NI2O/SO2R/OTRSP/Boxinside.jpg

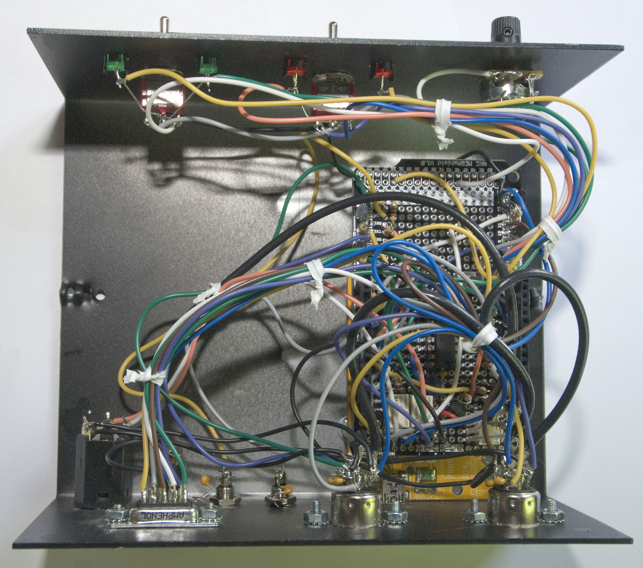
OTRSP/Boxinside.jpg
