NI2O/SO2R/OTRSP/SO2Rduino-V2.png

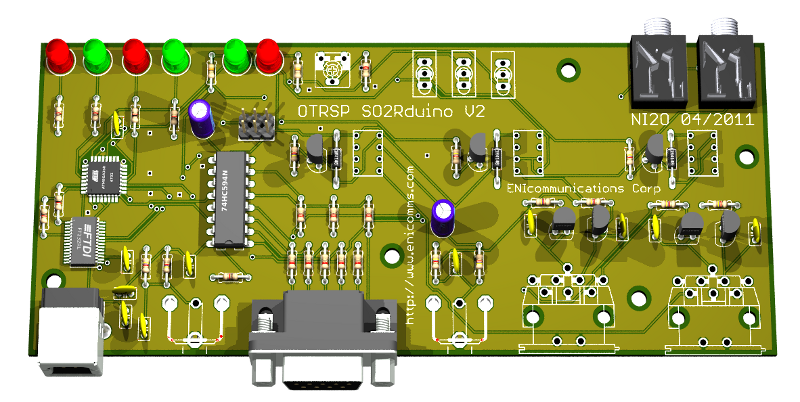
OTRSP/SO2Rduino-V2.png
