NI2O/SO2R/OTRSP/BoxFront.jpg

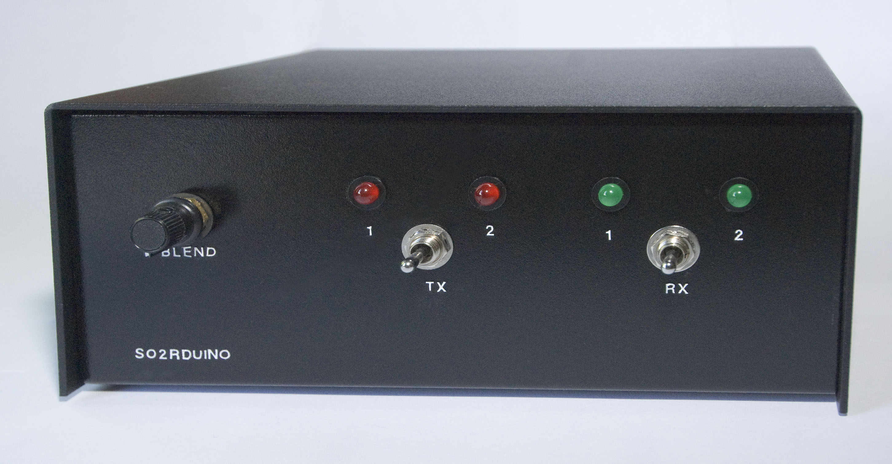
OTRSP/BoxFront.jpg
