NI2O/SO2R/OTRSP/Boxrear.jpg

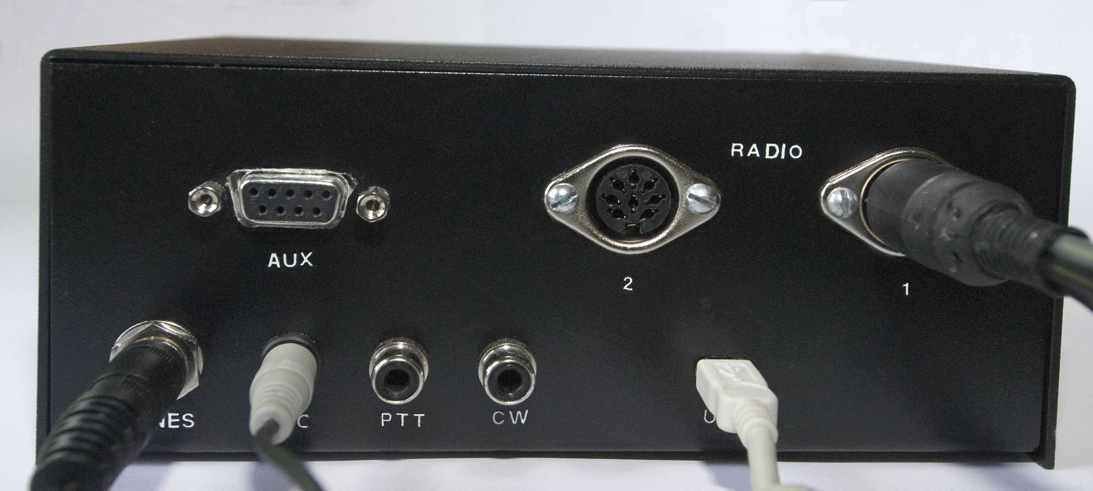
OTRSP/Boxrear.jpg
