NI2O/SO2R/OTRSP/SO2Rduino-V2-schematic.pdf

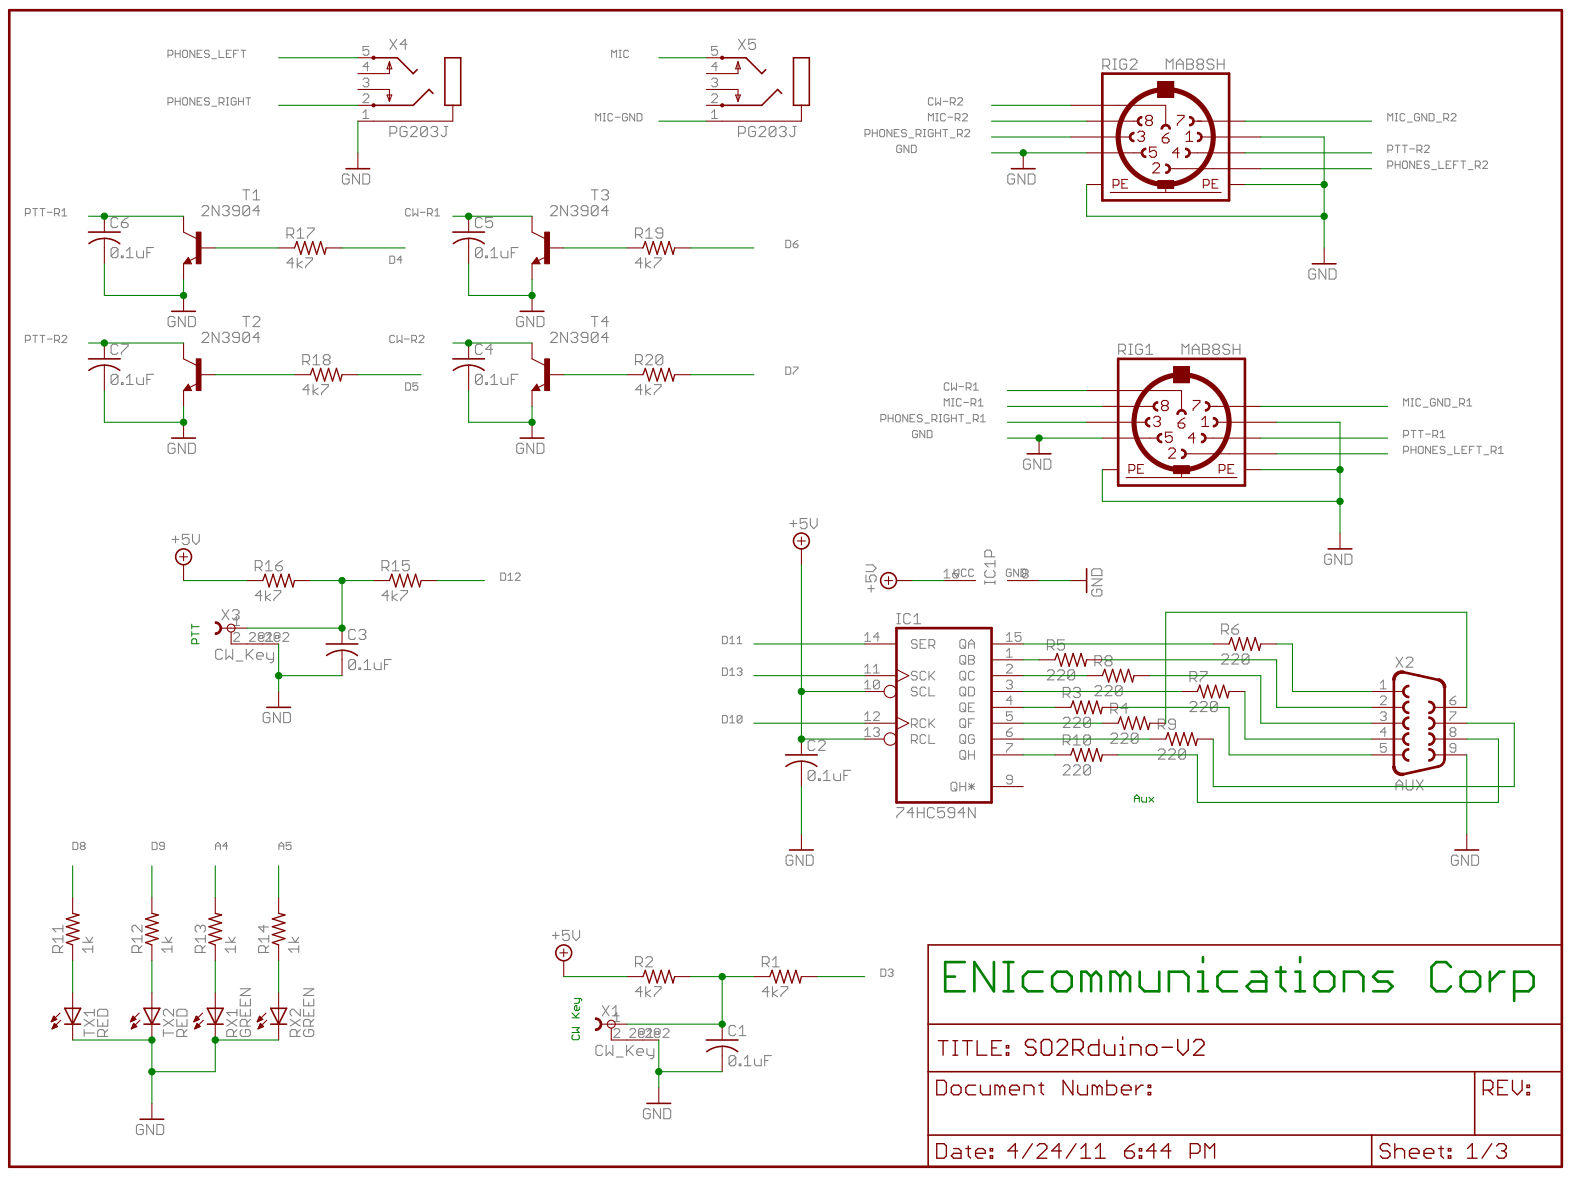
[picture p7: page 1]

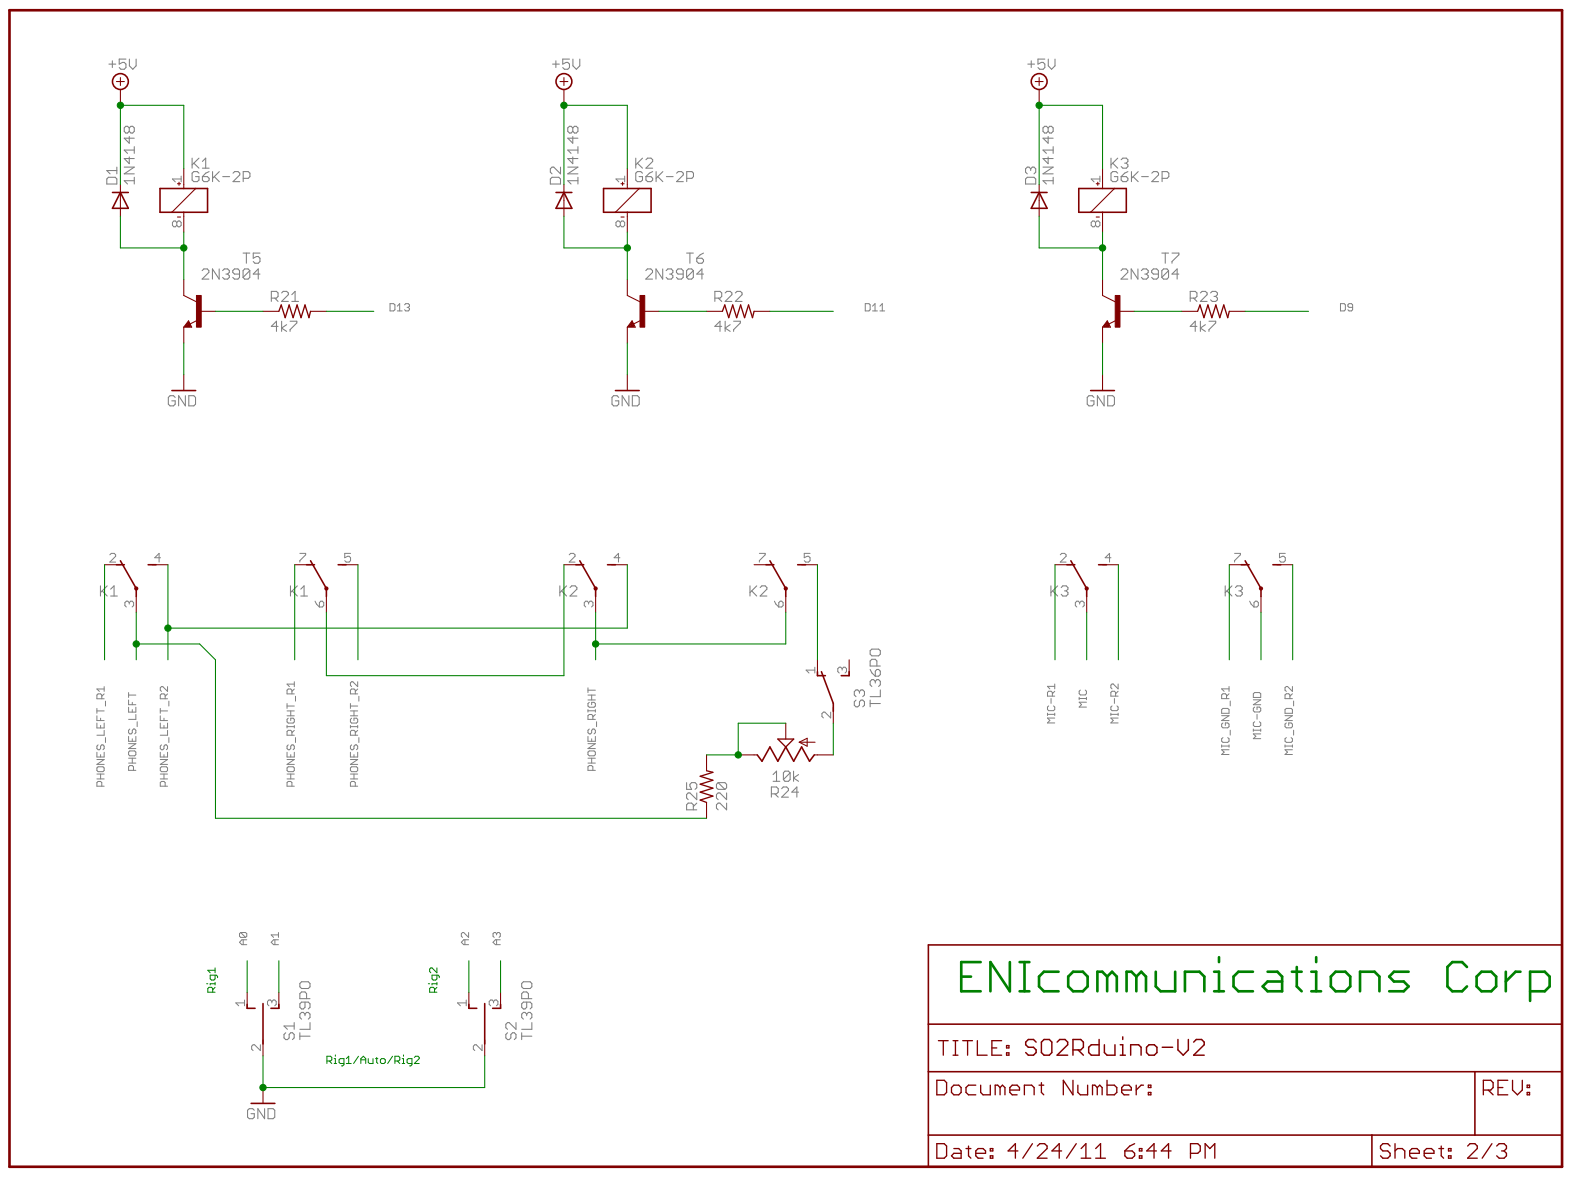
[picture p8: page 2]

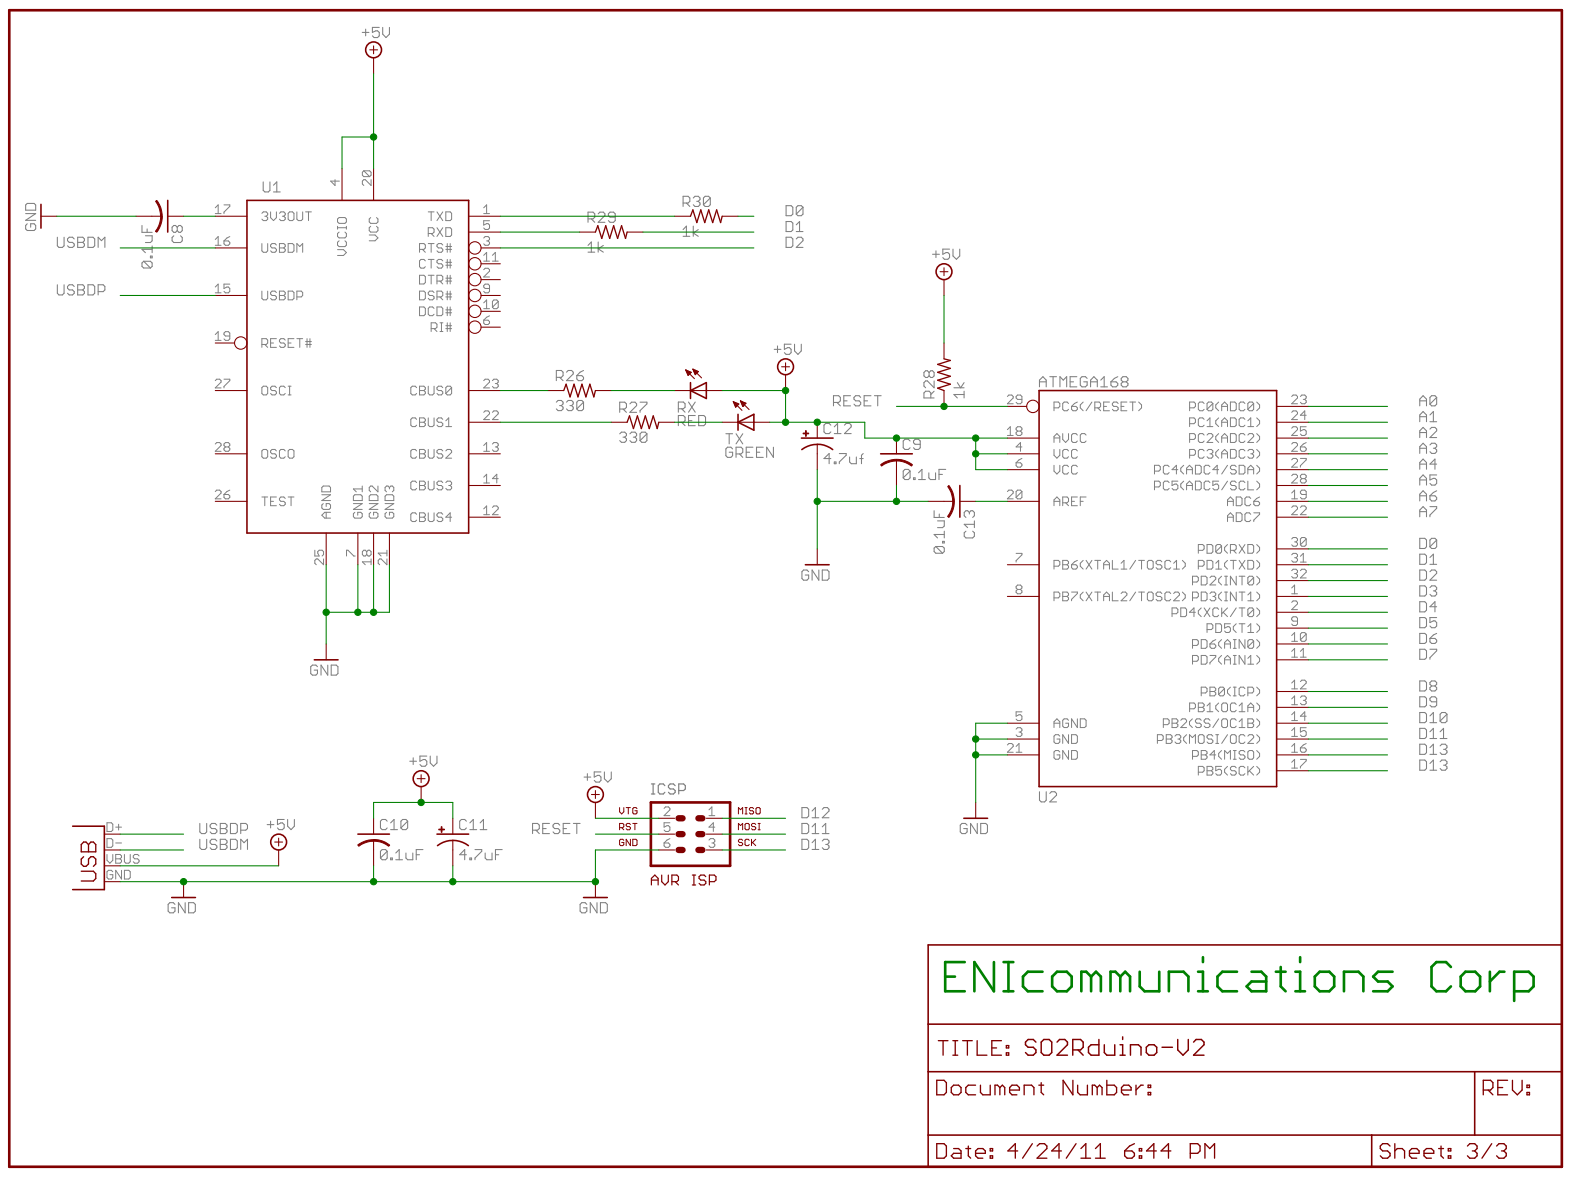
[picture p9: page 3]
