NI2O/SO2R/OTRSP/SO2Rduino-V2-board.pdf

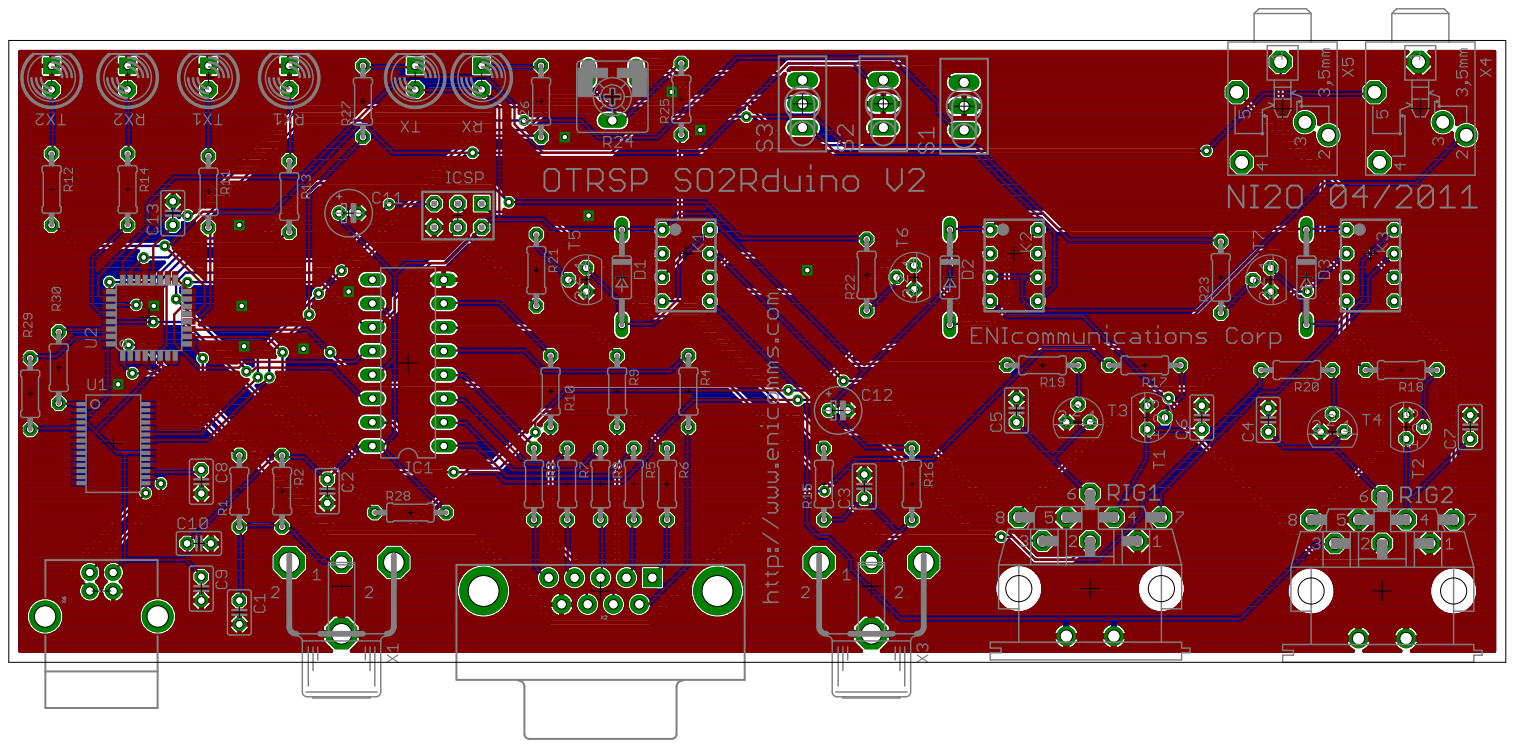
[picture p10: page 1]
