NI2O/SO2R/OTRSP/Software Install Instructions.docx

Instructions for Loading the SO2RDuino Software Into the K1XM SO2R Box

1) Go to the Arduino website, http://arduino.cc and
find the Downloads page.

2) Download and install the software for your environment
(It is available for Windows, Macintosh, and Linux).

3) Download and unzip the SO2RDuino.zip file.

4) Start the Arduino software and open the SO2RDuino file.

5) Follow the Arduino instructions to compile and to load
the firmware into the box.
